mkvenkit/humble_ice/images/hi-pcb.jpg

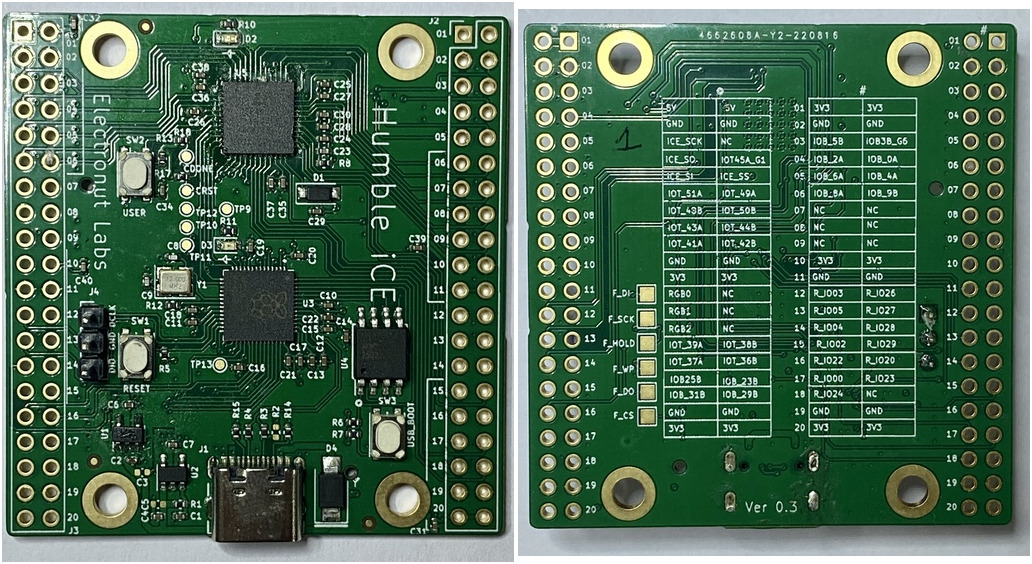
images/hi-pcb.jpg
