mkvenkit/humble_ice/hi_schematic_v_0.3.pdf

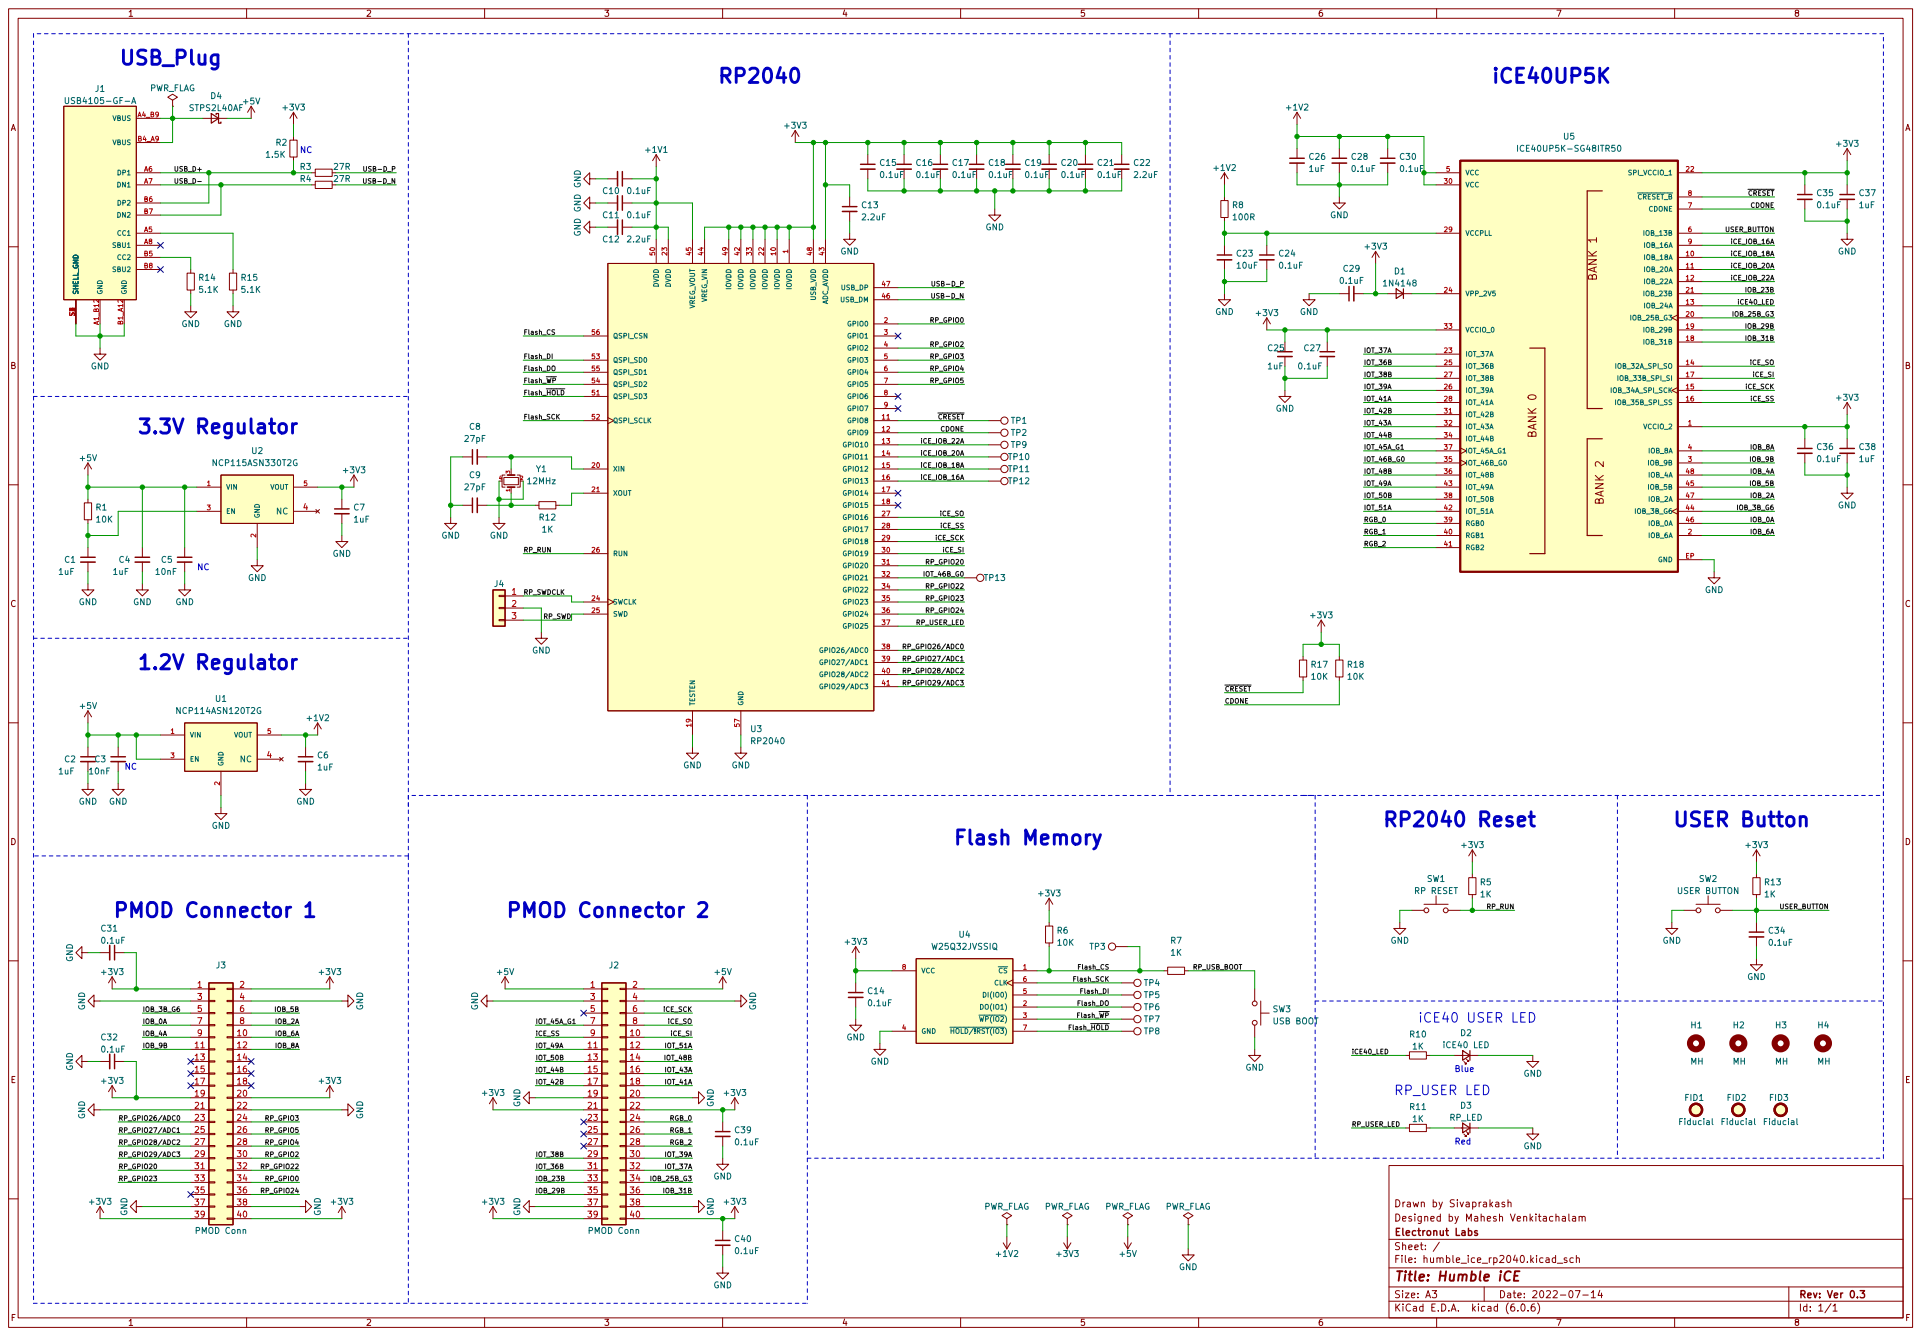
[picture p9: page 1]

ICE40UP5K-SG48ITR50 C22

48 VCC 5 3 VCC 30 0.1uF C23

1 IOVDD 10 GPIO8 11 GPIO9 12 GPIO10 13 GPIO11 14 GPIO12 15 GPIO13 16 GPIO14 17 GPIO15 18 TESTEN 19 GPIO0 2 XIN 20 XOUT 21 IOVDD 22 DVDD 23 SWCLK 24 SWD 25 RUN 26 GPIO16 27 GPIO17 28 GPIO18 29 GPIO1 3 GPIO19 30 GPIO20 31 GPIO21 32 IOVDD 33 GPIO22 34 GPIO23 35 GPIO24 36 GPIO25 37 GPIO26/ADC0 38 GPIO27/ADC1 39 GPIO2 4 GPIO28/ADC2 40 GPIO29/ADC3 41 IOVDD 42 ADC_AVDD 43 VREG_VIN 44 VREG_VOUT 45 USB_DM 46 USB_DP 47 USB_VDD 48 IOVDD 49 GPIO3 5 DVDD 50 QSPI_SD3 51 QSPI_SCLK 52 QSPI_SD0 53 QSPI_SD2 54 QSPI_SD1 55 QSPI_CSN 56 GND 57 GPIO4 6 GPIO5 7 GPIO6 8 GPIO7 9 U3RP2040

2 EN 3 VOUT 5 NC 4 U2 NCP115ASN330T2G GND

GND GND

Drawn by Sivaprakash
File: humble_ice_rp2040.kicad_sch Sheet: / Electronut Labs Designed by Mahesh Venkitachalam

Id: 1/1 Title: Humble iCE
