mkvenkit/humble_ice/examples/music_box/music.v

// Music demo verilog file
// (c) fpga4fun.com 2003-2015

// Plays a little tune on a speaker
// Use a 25MHz clock if possible (other frequencies will 
// change the pitch/speed of the song)

/////////////////////////////////////////////////////
module music(
	input clk_12Mhz,
	output reg speaker,
    output reg LED
);

// PLL 
wire clk;
wire locked;
pll pll25(
    .clock_in(clk_12Mhz),
    .clock_out(clk),
    .locked(locked)
);
  
// BEGIN - init hack
// iCE40 does not allow registers to initialised to 
// anything other than 0
// For workaround see:
// https://github.com/YosysHQ/yosys/issues/103
reg [7:0] resetn_counter = 0;
wire resetn = &resetn_counter;

always @(posedge clk) 
begin
    if (!resetn)
    begin
        resetn_counter <= resetn_counter + 1;
    end
end

// LED blink
reg [22:0] counter;
always @ (posedge clk) begin 
    if (!resetn) begin
        counter <= 0;
        LED <= 0;
    end
    else begin
        counter <= counter + 1;
        // LED blink
        if(!counter)
            LED <= ~LED;
    end
end


reg [30:0] tone;
always @(posedge clk) tone <= tone+31'd1;

wire [7:0] fullnote;
music_ROM get_fullnote(.clk(clk), .address(tone[29:22]), .note(fullnote));

wire [2:0] octave;
wire [3:0] note;
divide_by12 get_octave_and_note(.numerator(fullnote[5:0]), .quotient(octave), .remainder(note));

reg [8:0] clkdivider;
always @*
case(note)
	 0: clkdivider = 9'd511;//A
	 1: clkdivider = 9'd482;// A#/Bb
	 2: clkdivider = 9'd455;//B
	 3: clkdivider = 9'd430;//C
	 4: clkdivider = 9'd405;// C#/Db
	 5: clkdivider = 9'd383;//D
	 6: clkdivider = 9'd361;// D#/Eb
	 7: clkdivider = 9'd341;//E
	 8: clkdivider = 9'd322;//F
	 9: clkdivider = 9'd303;// F#/Gb
	10: clkdivider = 9'd286;//G
	11: clkdivider = 9'd270;// G#/Ab
	default: clkdivider = 9'd0;
endcase

reg [8:0] counter_note;
reg [7:0] counter_octave;
always @(posedge clk) counter_note <= counter_note==0 ? clkdivider : counter_note-9'd1;
always @(posedge clk) if(counter_note==0) counter_octave <= counter_octave==0 ? 8'd255 >> octave : counter_octave-8'd1;
always @(posedge clk) if(counter_note==0 && counter_octave==0 && fullnote!=0 && tone[21:18]!=0) speaker <= ~speaker;
endmodule


/////////////////////////////////////////////////////
module divide_by12(
	input [5:0] numerator,  // value to be divided by 12
	output reg [2:0] quotient, 
	output [3:0] remainder
);

reg [1:0] remainder3to2;
always @(numerator[5:2])
case(numerator[5:2])
	 0: begin quotient=0; remainder3to2=0; end
	 1: begin quotient=0; remainder3to2=1; end
	 2: begin quotient=0; remainder3to2=2; end
	 3: begin quotient=1; remainder3to2=0; end
	 4: begin quotient=1; remainder3to2=1; end
	 5: begin quotient=1; remainder3to2=2; end
	 6: begin quotient=2; remainder3to2=0; end
	 7: begin quotient=2; remainder3to2=1; end
	 8: begin quotient=2; remainder3to2=2; end
	 9: begin quotient=3; remainder3to2=0; end
	10: begin quotient=3; remainder3to2=1; end
	11: begin quotient=3; remainder3to2=2; end
	12: begin quotient=4; remainder3to2=0; end
	13: begin quotient=4; remainder3to2=1; end
	14: begin quotient=4; remainder3to2=2; end
	15: begin quotient=5; remainder3to2=0; end
endcase

assign remainder[1:0] = numerator[1:0];  // the first 2 bits are copied through
assign remainder[3:2] = remainder3to2;  // and the last 2 bits come from the case statement
endmodule
/////////////////////////////////////////////////////


module music_ROM(
	input clk,
	input [7:0] address,
	output reg [7:0] note
);

always @(posedge clk)
case(address)
	  0: note<= 8'd25;
	  1: note<= 8'd27;
	  2: note<= 8'd27;
	  3: note<= 8'd25;
	  4: note<= 8'd22;
	  5: note<= 8'd22;
	  6: note<= 8'd30;
	  7: note<= 8'd30;
	  8: note<= 8'd27;
	  9: note<= 8'd27;
	 10: note<= 8'd25;
	 11: note<= 8'd25;
	 12: note<= 8'd25;
	 13: note<= 8'd25;
	 14: note<= 8'd25;
	 15: note<= 8'd25;
	 16: note<= 8'd25;
	 17: note<= 8'd27;
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
	228: note<= 8'd20;
	229: note<= 8'd20;
	230: note<= 8'd29;
	231: note<= 8'd29;
	232: note<= 8'd27;
	233: note<= 8'd27;
	234: note<= 8'd25;
	235: note<= 8'd25;
	236: note<= 8'd25;
	237: note<= 8'd25;
	238: note<= 8'd25;
	239: note<= 8'd25;
	240: note<= 8'd25;
	241: note<= 8'd0;
	242: note<= 8'd00;
	default: note <= 8'd0;
endcase
endmodule

/////////////////////////////////////////////////////
