mkvenkit/humble_ice/examples/music_box/pll.v

/**
 * PLL configuration
 *
 * This Verilog header file was generated automatically
 * using the icepll tool from the IceStorm project.
 * It is intended for use with FPGA primitives SB_PLL40_CORE,
 * SB_PLL40_PAD, SB_PLL40_2_PAD, SB_PLL40_2F_CORE or SB_PLL40_2F_PAD.
 * Use at your own risk.
 *
 * Given input frequency:        12.000 MHz
 * Requested output frequency:   25.000 MHz
 * Achieved output frequency:    25.125 MHz
 */

module pll(
	input  clock_in,
	output clock_out,
	output locked
	);

SB_PLL40_PAD #(
		.FEEDBACK_PATH("SIMPLE"),
        .DIVR(4'b0000),		// DIVR =  0
        .DIVF(7'b1000010),	// DIVF = 66
        .DIVQ(3'b101),		// DIVQ =  5
        .FILTER_RANGE(3'b001)	// FILTER_RANGE = 1
	) uut (
		.LOCK(locked),
		.RESETB(1'b1),
		.BYPASS(1'b0),
		.PACKAGEPIN (clock_in),
		.PLLOUTCORE(clock_out)
		);

endmodule
